ut-robotics/picr21-team-robothree/electronics/Mainboard.pdf

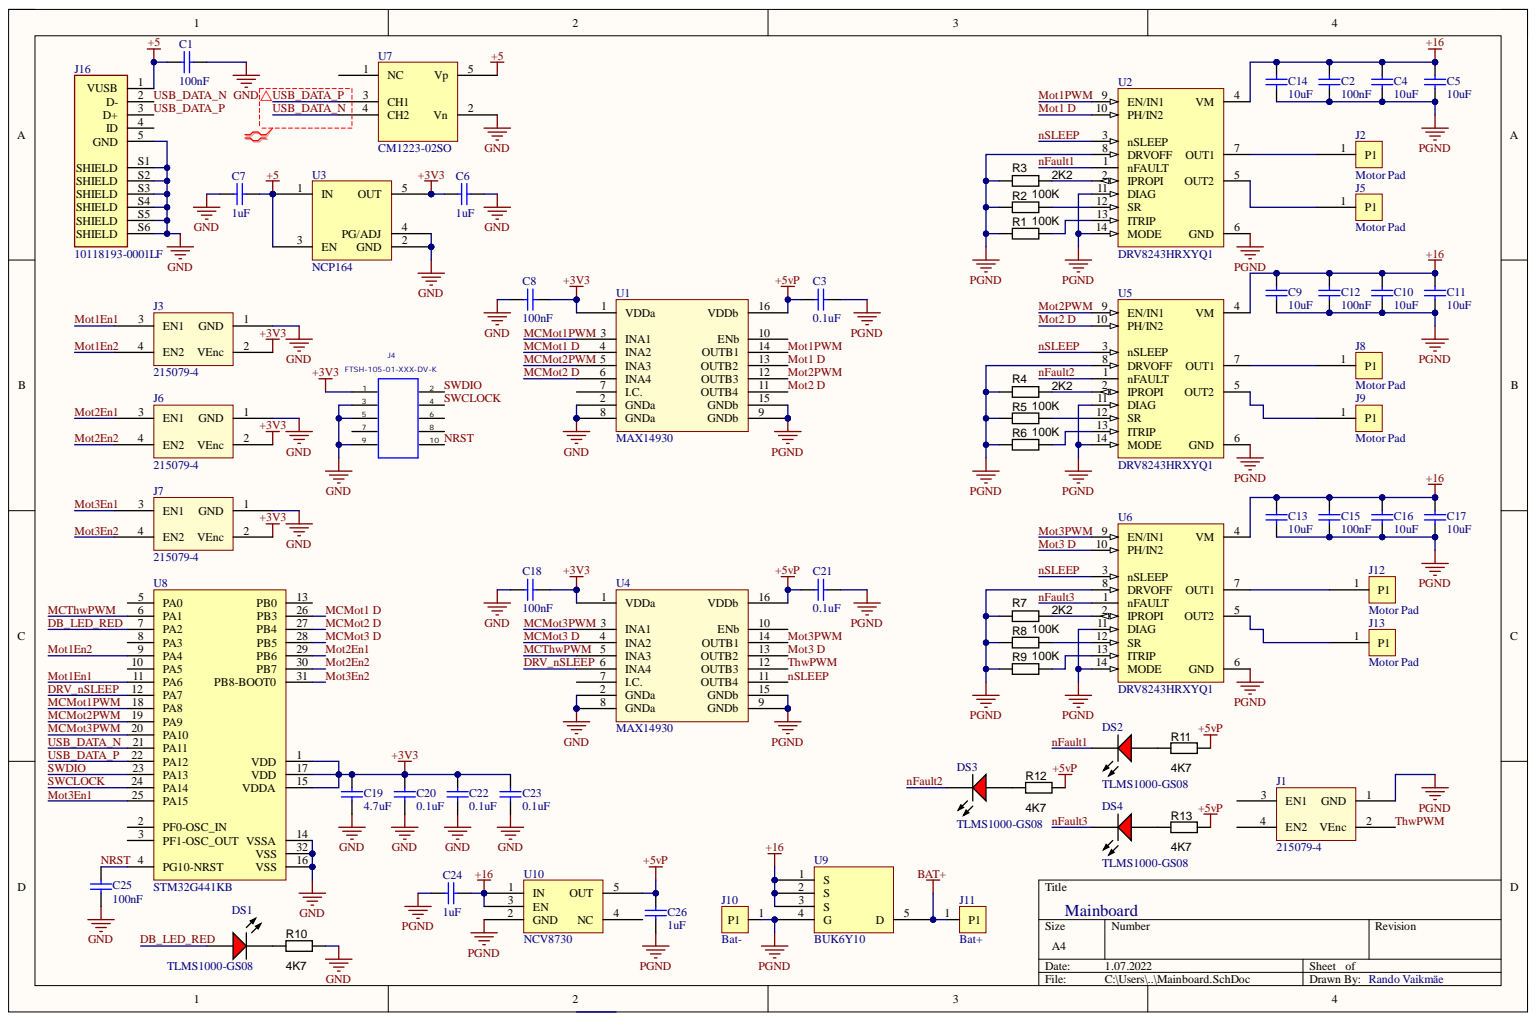
[picture p1: page 1]
