ut-robotics/picr21-team-robothree/electronics/robothreePCB.pdf

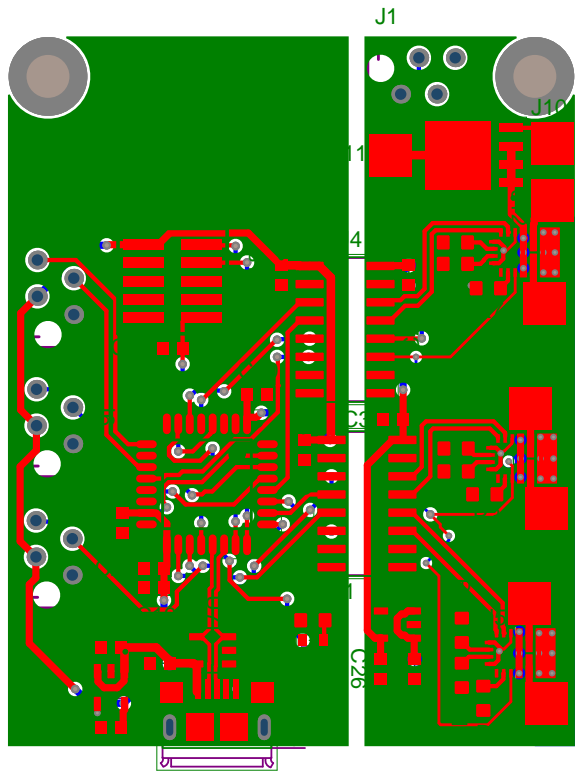
[picture p2: page 1]
