ut-robotics/picr21-team-robothree/(list of files, drawings)

Other design files:
electronics/215079-4.SchLib
electronics/Batteryterminal.SchLib
electronics/BUK6Y10.SchLib
electronics/CM1223-2SO.SchLib
electronics/Comp_robotics.PrjPcb
electronics/DRV8243.SchLib
electronics/DRV8243FP.PcbLib
electronics/Mainboard.SchDoc
electronics/MAX14930.SchLib
electronics/Motorpad.SchLib
electronics/NCP164.SchLib
electronics/NCV8730.SchLib
electronics/NCV8730fp.PcbLib
electronics/Pads.PcbLib
electronics/Robothree.PcbLib
electronics/robothreePCB.PcbDoc
electronics/STM32.PcbLib
electronics/STM32G441KB.SchLib
