ut-robotics/picr21-team-robothree/(threads)

Thread 2 (2021-11-16):

Avoid using globals as much as possible

Akustav, 2021-11-16:
https://github.com/ut-robotics/picr21-team-robothree/blob/c8fd9f971ac10de60257a899a258b217f0f8c454/robot_control.py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

Avoid using global variables whenever possible. When sending speeds to motor maybe give them as an argument for the send method.

Thread 9 (2021-11-16):

Refactor image processing module to be separated

Akustav, 2021-11-16:
Refactoring of the camera_test.py is needed. Camera acquisition and thresholding should be its separate modules since they are needed by the robot logic as well.

As standalone modules they help to increase code re-use and avoid copy-paste code where, for example, calibration and internal robot logic use different camera parameters.

Thread 13 (2021-11-17):

[Mechanics] - flattening of components done in design, not manufacturing model

Akustav, 2021-11-17:
Flatterning of components should be done in the manufacturing model. Currently it is in the design:
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

It can be accessed here. The advantage is, that the models assembly is not affected by changes there.:
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

Closed 2021-11-18.

Thread 16 (2021-11-18):

[Mechanics] - slot not cut out and cutout seems a little too small

Akustav, 2021-11-18:
The slot is not cut:
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

Additionally, it does not cut out in multiple depths and the slot is not wide enough:
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

Closed 2021-11-18.

Thread 17 (2022-01-05):

Add grounds to both internal layers

ReikoR, 2022-01-05:
Separate GND and PGND polygons should be placed on both internal layers.

Layer 2 ground is reference plane for signals and power on top layer and layer 3 ground is reference plane for signals and power on bottom layer.

Closed 2022-01-07.

Thread 20 (2022-01-05):

Use wider tracks/polygons and more vias for higher currents

ReikoR, 2022-01-05:
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

0.6 mm track can carry about 1.8 A of current with 20 degree temperature rise:

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

Average current for 3 motors might be higher and it is a good practice to have overhead. Extra copper also helps with cooling the components.

Saturn PCB Design Toolkit can be downloaded from here:
https://saturnpcb.com/saturn-pcb-toolkit/

ReikoR, 2022-01-07:
1. **Polygons not connected to tracks.**

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

Use following settings for polygons:
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

2. **Use wider connections for BAT+ and +16V.**

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

Closed 2022-01-07.

Thread 22 (2022-01-05):

Fix DRC errors

ReikoR, 2022-01-05:
Run DRC with **Tools -> Design Rule Check...**

1. **Short-Circuit**

Remove extra holes inside USB connector footprint slots.

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

2. **Un-Routed Net**

Some of the capacitors are not connected to PGND.

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

3. **Hole To Hole Clearance**

Extra holes in USB connector slots cause this.

Also there are vias in micromatch through-hole pads. Through-hole pads work same way as vias and don't need any vias.

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

Closed 2022-01-07.
