ut-robotics/picr21-team-robothree/(commit log)

2021-09-24 first small camera demo
2021-11-15 deleting unneeded code and some camera stuff in production
2021-11-16 started fixing issues #1 #7 #4 #5
    [camera_test.py, manual_mov.py, robot_control.py]
2021-11-16 fixes to #3 implementation and start of #9 added extra debug bool for currently only trackbars
    [camera_test.py, manual_mov.py]
2021-12-09 Electronics, first schematic push.
    [215079-4.SchLib, BUK6Y10.SchLib, Batteryterminal.SchLib, CM1223-2SO.SchLib, Comp_robotics.PrjPcb, DRV8243.SchLib, DRV8243FP.PcbLib, MAX14930.SchLib]
2022-01-05 #Added PCB, some minor tweaks and review needed
    [Comp_robotics.PrjPcb, DRV8243.SchLib, Mainboard.SchDoc, Motorpad.SchLib, NCP164.SchLib, Pads.PcbLib, robothreePCB.PcbDoc]
2022-01-05 #PDF files for preview
    [Comp_robotics.PrjPcb]
2022-01-06 # Finished PCB design
    [CM1223-2SO.SchLib, Comp_robotics.PrjPcb, Mainboard.SchDoc, Robothree.PcbLib, robothreePCB.PcbDoc]
2022-01-06 # Decided to add nFault leds to motor drivers, hopefully they suit fine.
    [Comp_robotics.PrjPcb, Mainboard.SchDoc, robothreePCB.PcbDoc]
2022-01-06 # Fixed component designator placements
    [robothreePCB.PcbDoc]
2022-01-07 # Fixed the last issues and added latest schematic pdf
    [robothreePCB.PcbDoc]
2022-01-07 #Made the polygon and put some more vias
    [robothreePCB.PcbDoc]
2022-01-07 # Wider polygon + lost PGND vias and tracked them instead
    [robothreePCB.PcbDoc]
2022-01-07 # Gerber file + NC Drill files and added board shape primitive to mechanical layer 1
    [Comp_robotics.PrjPcb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]
2022-01-07 # Fixed Mechanical layer issues and made new gerber
    [Comp_robotics.PrjPcb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]
